prior-philip/AirSuspension_ESP32/hardware/FCU/FCU.csv

Reference | Qty | Value | DNP | Exclude from BOM | Exclude from Board | Footprint | Datasheet
C1 | 1 | 470uF |  |  |  | Capacitor_THT:CP_Radial_D14.0mm_P5.00mm | ~
C2 | 1 | 47uF |  |  |  | Capacitor_THT:CP_Radial_D12.5mm_P5.00mm | ~
C3,C4 | 2 | 47pF |  |  |  | Capacitor_THT:C_Rect_L7.0mm_W3.5mm_P5.00mm | ~
C5 | 1 | 10uF |  |  |  | Capacitor_THT:CP_Radial_D5.0mm_P2.50mm | ~
C6,C7,C8 | 3 | 470pF |  |  |  | Capacitor_THT:C_Rect_L7.0mm_W3.5mm_P5.00mm | ~
D1,D2,D3,D4 | 4 | 1N4003 |  |  |  | Diode_THT:D_DO-41_SOD81_P2.54mm_Vertical_AnodeUp
J1 | 1 | Pneumatic Valves |  |  |  | Connector_PinHeader_2.54mm:PinHeader_1x08_P2.54mm_Vertical | ~
J2 | 1 | UP/DOWN Switch |  |  |  | Connector_PinHeader_2.54mm:PinHeader_1x04_P2.54mm_Vertical | ~
J3 | 1 | OLED Display |  |  |  | Connector_PinHeader_2.54mm:PinHeader_1x04_P2.54mm_Vertical | ~
J4 | 1 | NiveauSensor |  |  |  | Connector_PinHeader_2.54mm:PinHeader_1x06_P2.54mm_Vertical | ~
J5 | 1 | Power In |  |  |  | Connector_PinHeader_2.54mm:PinHeader_1x04_P2.54mm_Vertical | ~
Q1,Q2,Q3,Q4 | 4 | IRLU120 |  |  |  | Package_TO_SOT_THT:TO-220-3_Vertical | https://www.vishay.com/docs/91326/sihlz24.pdf
R1,R2,R3,R4 | 4 | 10k |  |  |  | Resistor_THT:R_Axial_DIN0207_L6.3mm_D2.5mm_P10.16mm_Horizontal | ~
U1 | 1 | LM7805_TO220 |  |  |  | Package_TO_SOT_THT:TO-220-3_Vertical | https://www.onsemi.cn/PowerSolutions/document/MC7800-D.PDF
U2 | 1 | Arduino_Nano_v3.x |  |  |  | Module:Arduino_Nano | http://www.mouser.com/pdfdocs/Gravitech_Arduino_Nano3_0.pdf
