prior-philip/AirSuspension_ESP32/hardware/FCU/Documents/FCU.pdf

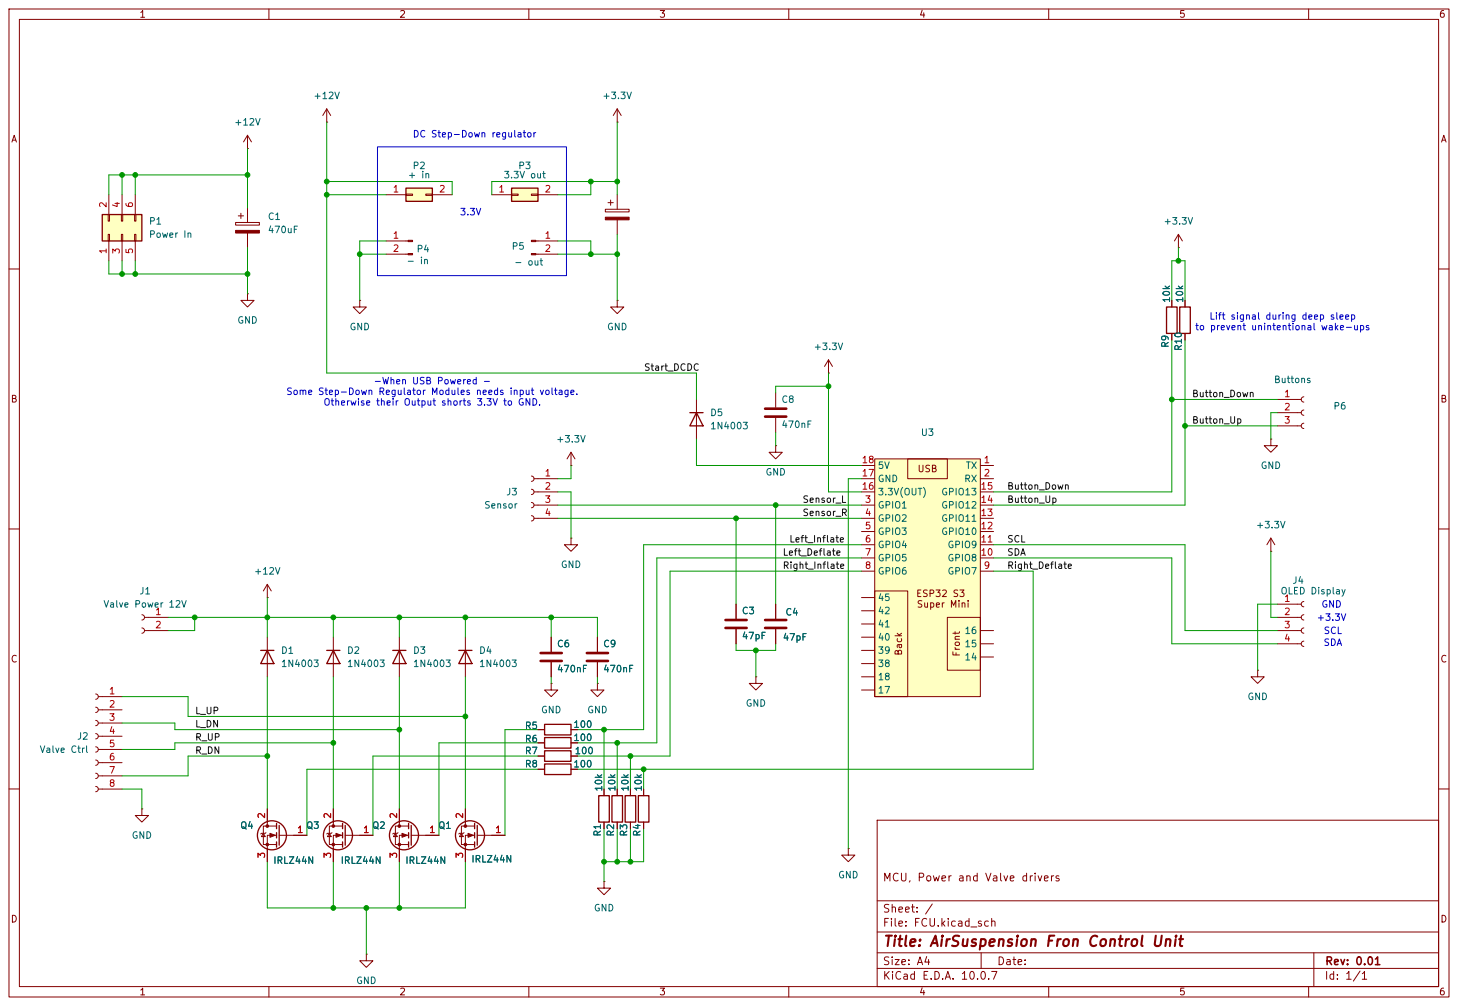
[picture p1: page 1]

to prevent unintentional wake-ups 3.3V Q1

Lift signal during deep sleep

MCU, Power and Valve drivers GND

Sheet: /
File: FCU.kicad_sch
Title: AirSuspension Fron Control Unit

Size: A4 | Rev: 0.01
KiCad E.D.A. 10.0.7 | Id: 1/1
