prior-philip/AirSuspension_ESP32/hardware/RCU/Output/RCU.pdf

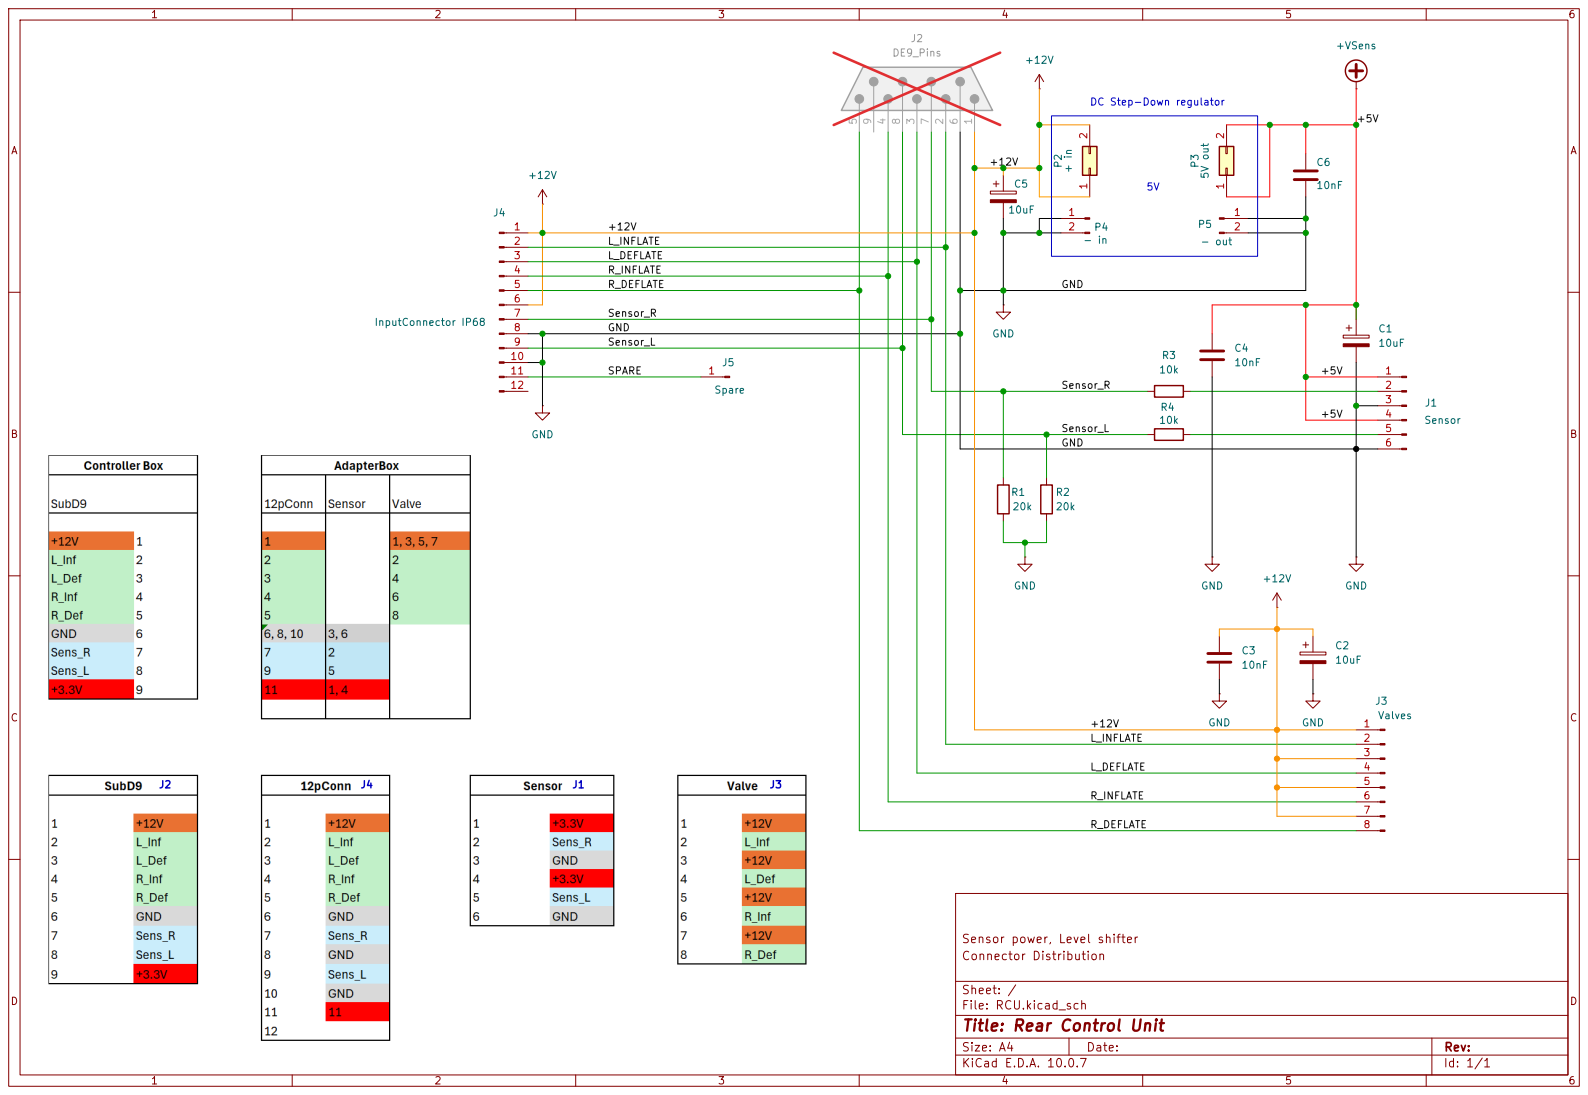
[picture p2: page 1]

5V DC Step-Down regulator

Sheet: /
File: RCU.kicad_sch
Title: Rear Control Unit

Size: A4 | Rev:
KiCad E.D.A. 10.0.7 | Id: 1/1
