prior-philip/AirSuspension_ESP32/hardware/FCU/Documents/VW-1234-20001/VW-1234-20001-ASMTOP.pdf

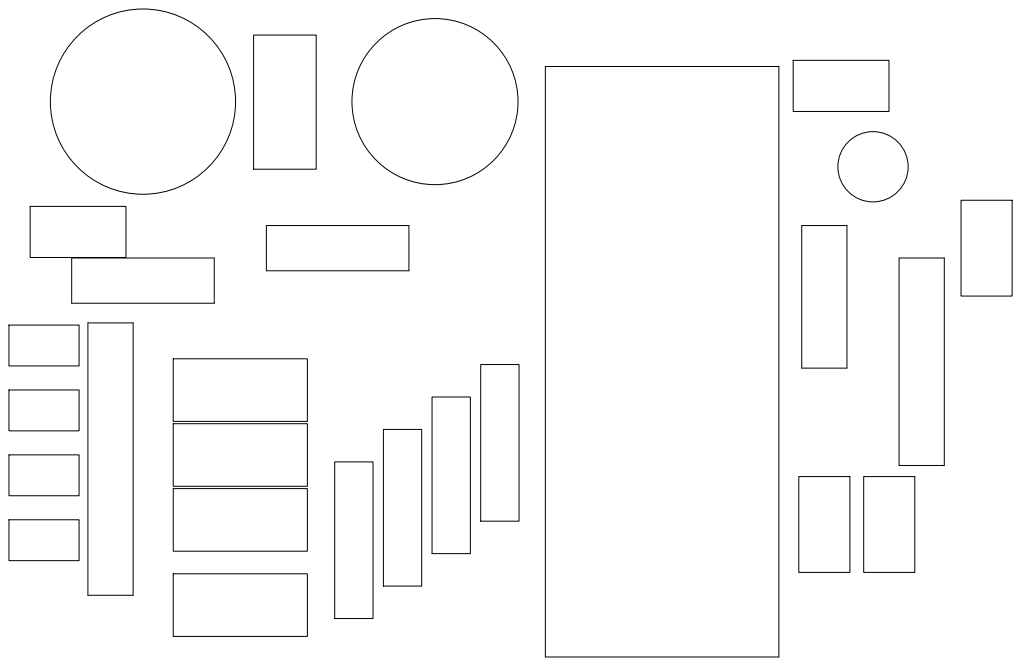
[picture p4: page 1]

Id: 1/1 Title: File: AirSuspension.kicad_pcb Sheet:
