prior-philip/AirSuspension_ESP32/hardware/FCU/Documents/VW-1234-20001/VW-1234-20001-SCH.pdf

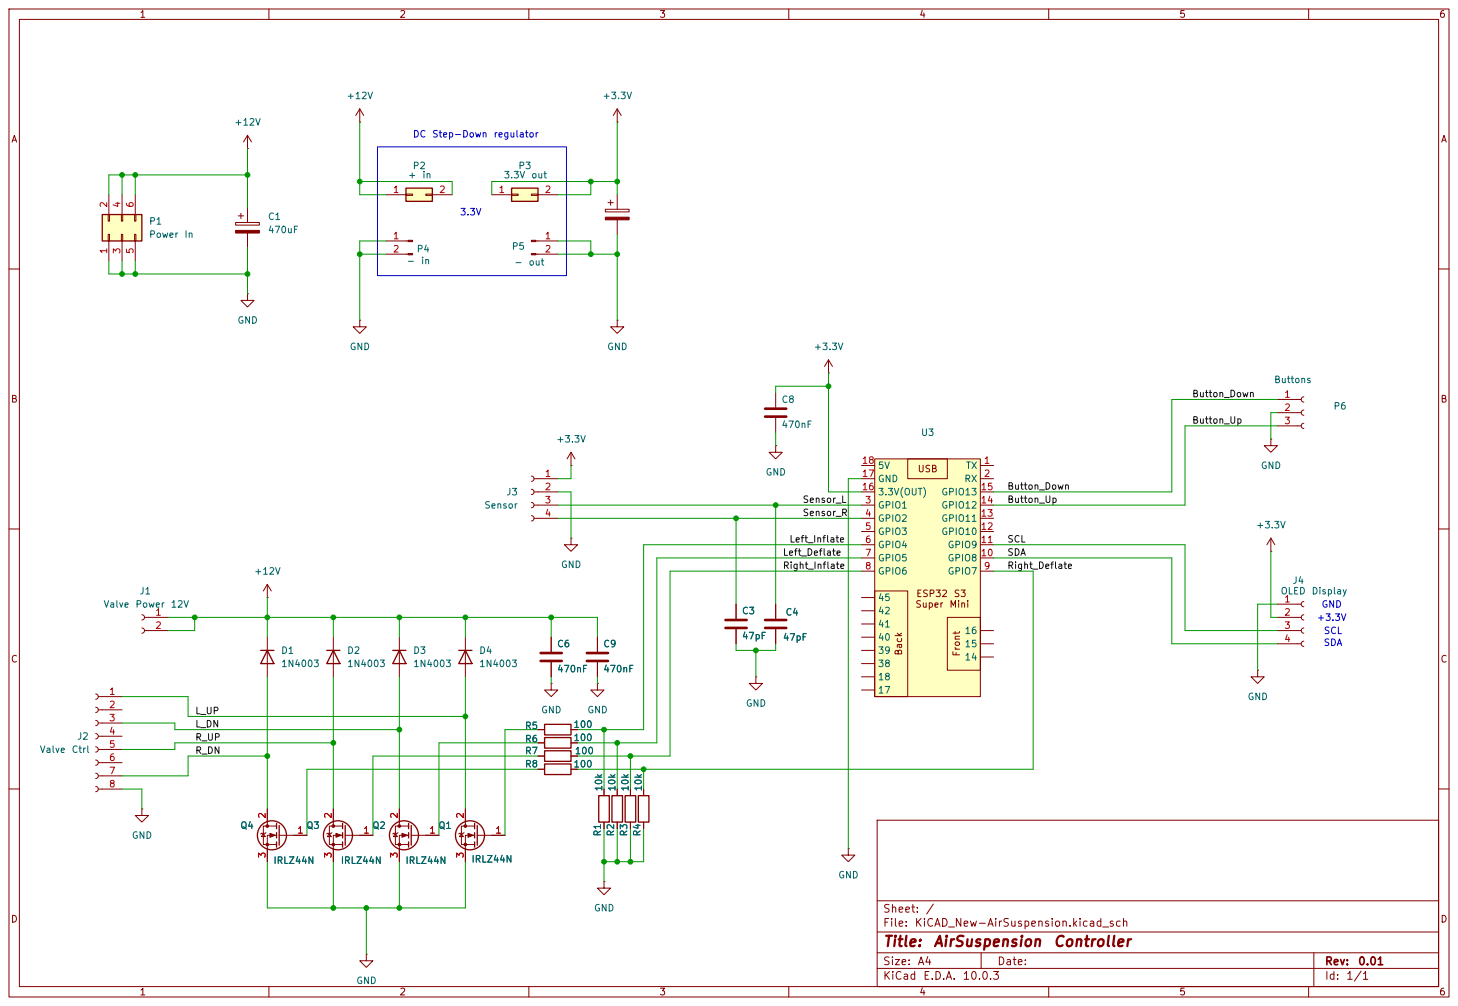
[picture p5: page 1]

Size: A4 | Rev: 0.01
KiCad E.D.A. 10.0.3 | Id: 1/1
