prior-philip/AirSuspension_ESP32/hardware/FCU/Documents/schemtic.pdf

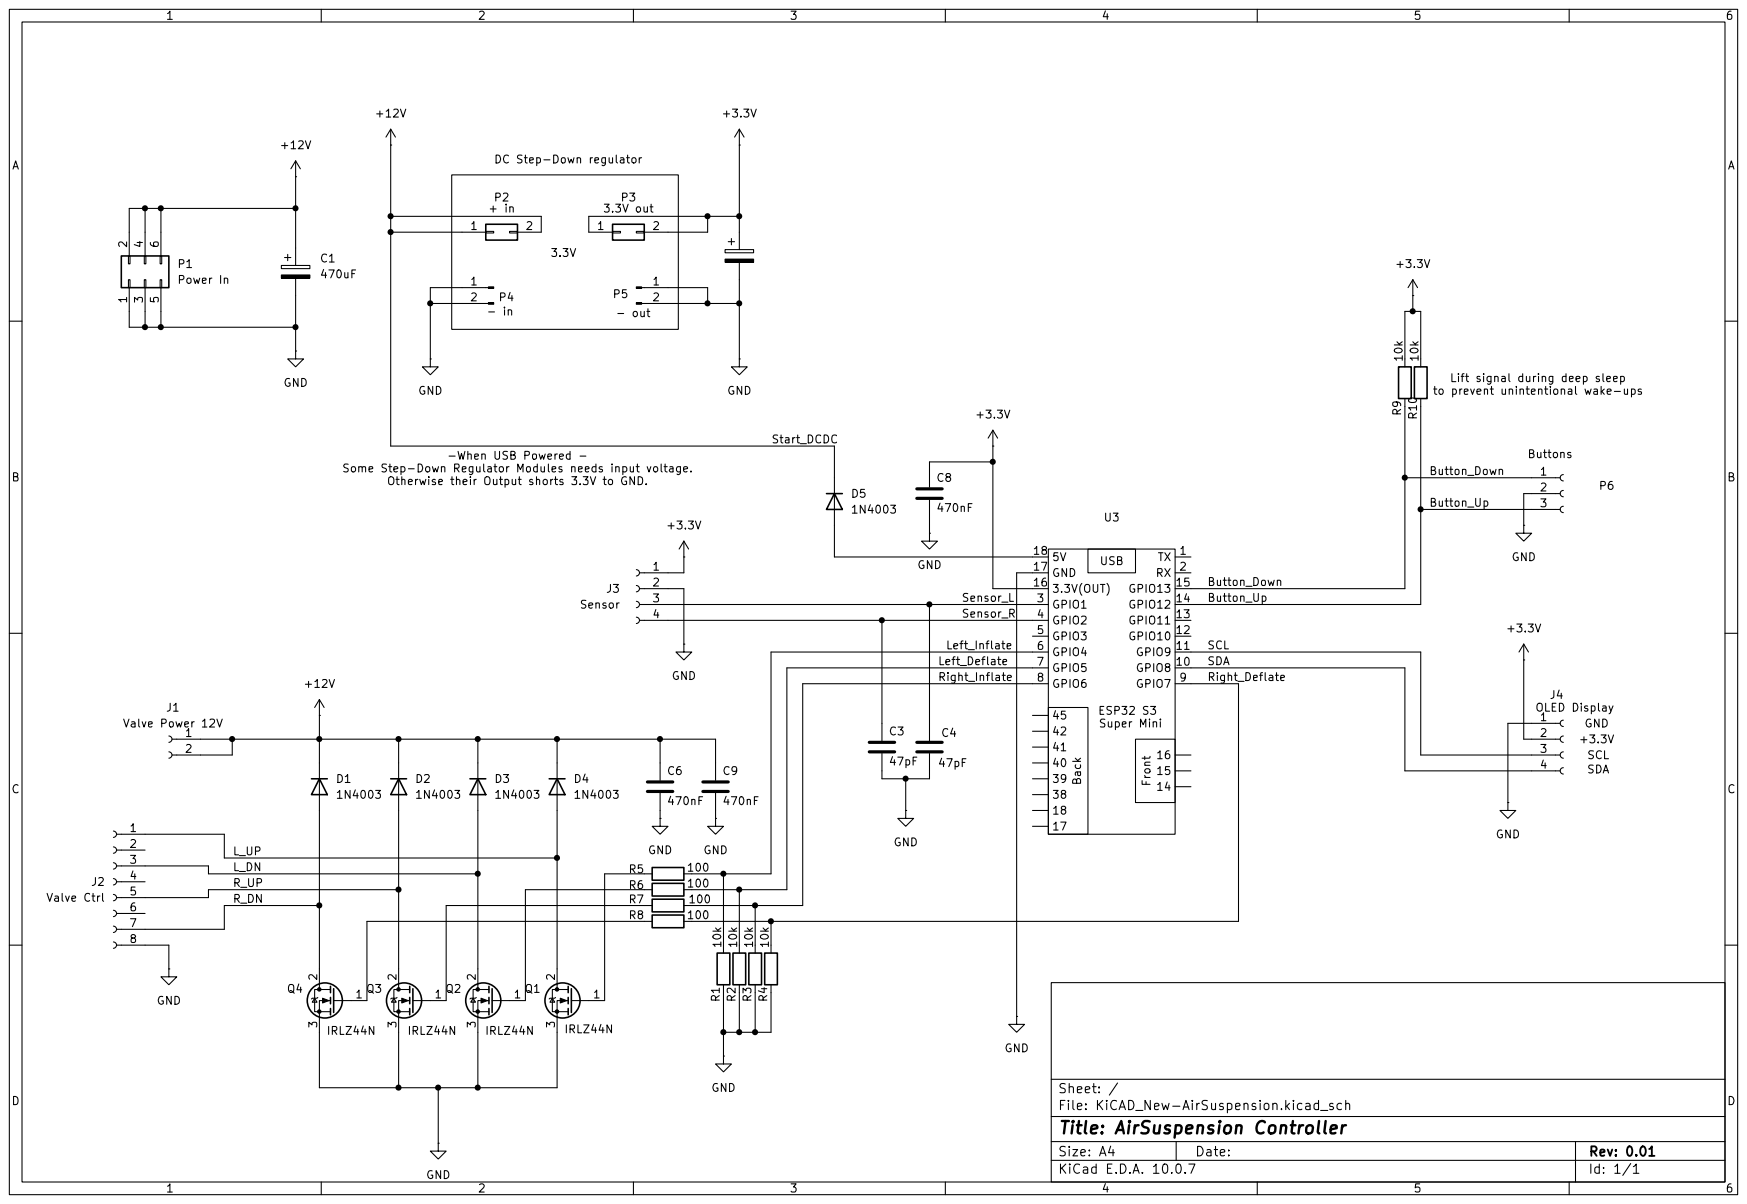
[picture p6: page 1]
