prior-philip/AirSuspension_ESP32/hardware/FCU/Documents/VW-1234-20001/KiCAD_New-AirSuspension-F_Mask.pdf

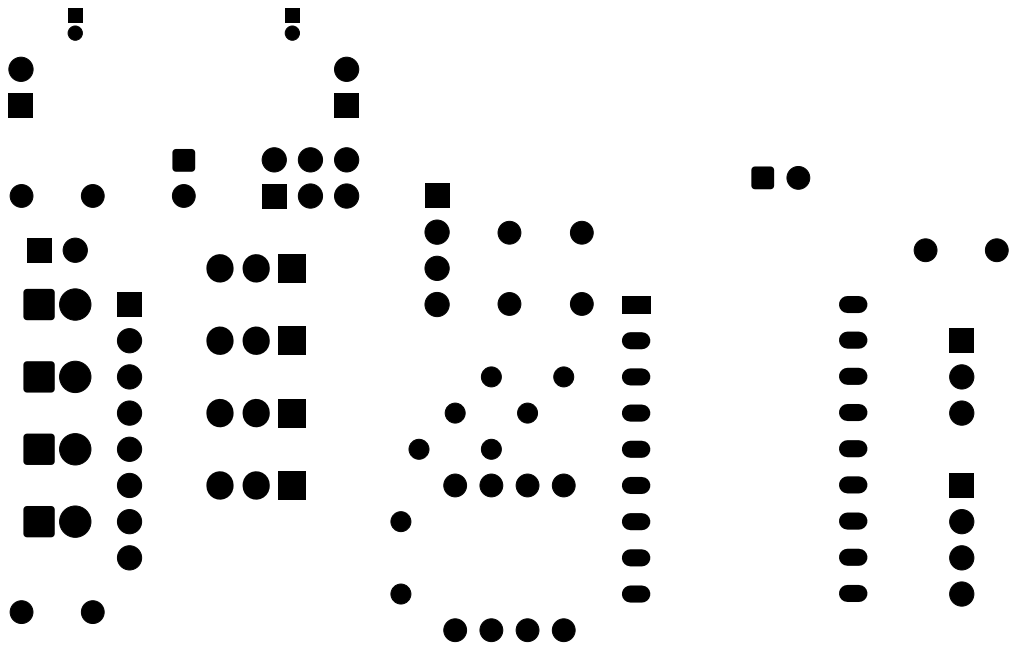
[picture p7: page 1]
