prior-philip/AirSuspension_ESP32/hardware/FCU/FCU.kicad_pcb

## KiCad design hardware/FCU/FCU.kicad_pcb (2026-10-25)

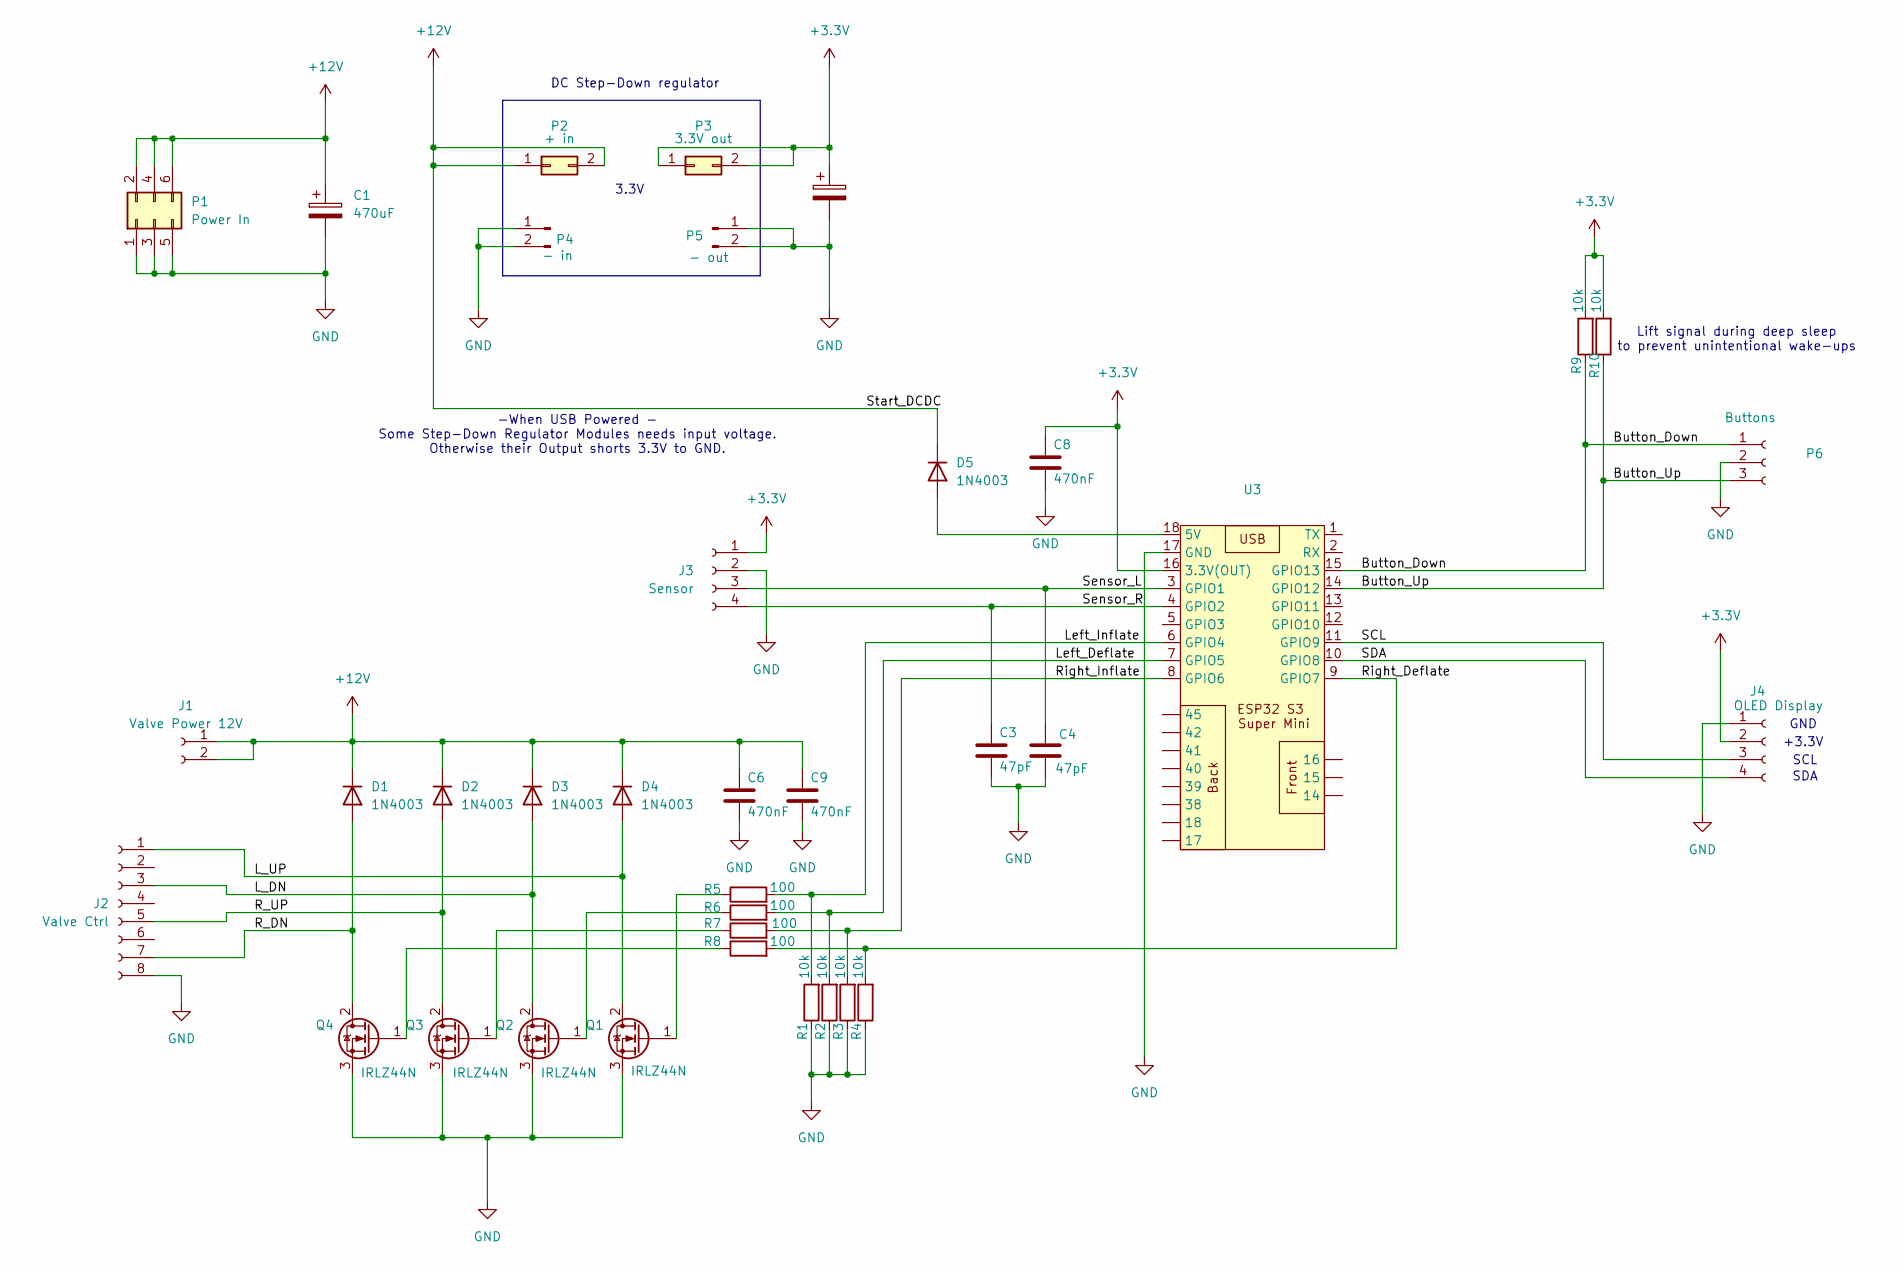
[picture p9: schematic FCU.kicad_sch, AirSuspension Fron Control Unit]

Parts:
C1: 470uF; CP_Radial_D6.3mm_P2.50mm
C2: 47uF; CP_Radial_D6.3mm_P2.50mm
C3, C4: 47pF; C_Rect_L7.0mm_W3.5mm_P5.00mm
C6, C8, C9: 470nF; C_Rect_L7.0mm_W3.5mm_P5.00mm
D1, D2, D3, D4: 1N4003; D_DO-41_SOD81_P2.54mm_Vertical_AnodeUp
D5: 1N4003; D_A-405_P10.16mm_Horizontal
J1: Valve Power 12V; PinSocket_1x02_P2.54mm_Vertical
J2: Valve Ctrl; PinSocket_1x08_P2.54mm_Vertical
J3: Sensor; PinSocket_1x04_P2.54mm_Vertical
J4: OLED Display; PinSocket_1x04_P2.54mm_Vertical
P1: Power In; PinHeader_2x03_P2.54mm_Vertical
P2: + in; PinHeader_2x01_P2.54mm_Horizontal
P3: 3.3V out; PinHeader_2x01_P2.54mm_Horizontal
P4: - in; PinHeader_1x02_P1.27mm_Vertical
P5: - out; PinHeader_1x02_P1.27mm_Vertical
P6: Buttons; PinHeader_1x03_P2.54mm_Vertical
Q1, Q2, Q3, Q4: IRLZ44N; TO-220-3_Vertical
R1, R2, R3, R4, R9: 10k; R_Axial_DIN0207_L6.3mm_D2.5mm_P10.16mm_Horizontal
R5, R6, R7, R8: 100; R_Axial_DIN0204_L3.6mm_D1.6mm_P5.08mm_Horizontal
R10: 10k; R_Axial_DIN0207_L6.3mm_D2.5mm_P2.54mm_Vertical
U3: ESP32-S3-SuperMini

Connections:
+3.3V: C2.1, C8.1, J3.1, J4.2, P3.1, P3.2, R9.2, R10.2, U3.16 (3.3V(OUT))
+12V: C1.1, C6.1, C9.1, D1.1 (K), D2.1 (K), D3.1 (K), D4.1 (K), D5.1 (K), J1.1, J1.2, P1.2, P1.4, P1.6, P2.1, P2.2
/Button_Down: P6.1, R9.1, U3.15 (GPIO13)
/Button_Up: P6.3, R10.1, U3.14 (GPIO12)
/L_DN: D3.2 (A), J2.3, Q2.2 (D)
/L_UP: D4.2 (A), J2.1, Q1.2 (D)
/Left_Deflate: R2.2, R6.2, U3.7 (GPIO5)
/Left_Inflate: R1.2, R5.2, U3.6 (GPIO4)
/R_DN: D1.2 (A), J2.7, Q4.2 (D)
/R_UP: D2.2 (A), J2.5, Q3.2 (D)
/Right_Deflate: R4.2, R8.2, U3.9 (GPIO7)
/Right_Inflate: R3.2, R7.2, U3.8 (GPIO6)
/SCL: J4.3, U3.11 (GPIO9)
/SDA: J4.4, U3.10 (GPIO8)
/Sensor_L: C4.1, J3.3, U3.3 (GPIO1)
/Sensor_R: C3.1, J3.4, U3.4 (GPIO2)
GND: C1.2, C2.2, C3.2, C4.2, C6.2, C8.2, C9.2, J2.8, J3.2, J4.1, P1.1, P1.3, P1.5, P4.1, P4.2, P5.1, P5.2, P6.2, Q1.3 (S), Q2.3 (S), Q3.3 (S), Q4.3 (S), R1.1, R2.1, R3.1, R4.1, U3.17 (GND)
unnamed: D5.2 (A), U3.18 (5V)
unnamed: Q1.1 (G), R5.1
unnamed: Q2.1 (G), R6.1
unnamed: Q3.1 (G), R7.1
unnamed: Q4.1 (G), R8.1

Notes on the sheet:
GND
-When USB Powered - Some Step-Down Regulator Modules needs input voltage. Otherwise their Output shorts 3.3V to GND.
DC Step-Down regulator
SDA
3.3V
+3.3V
Lift signal during deep sleep to prevent unintentional wake-ups
SCL

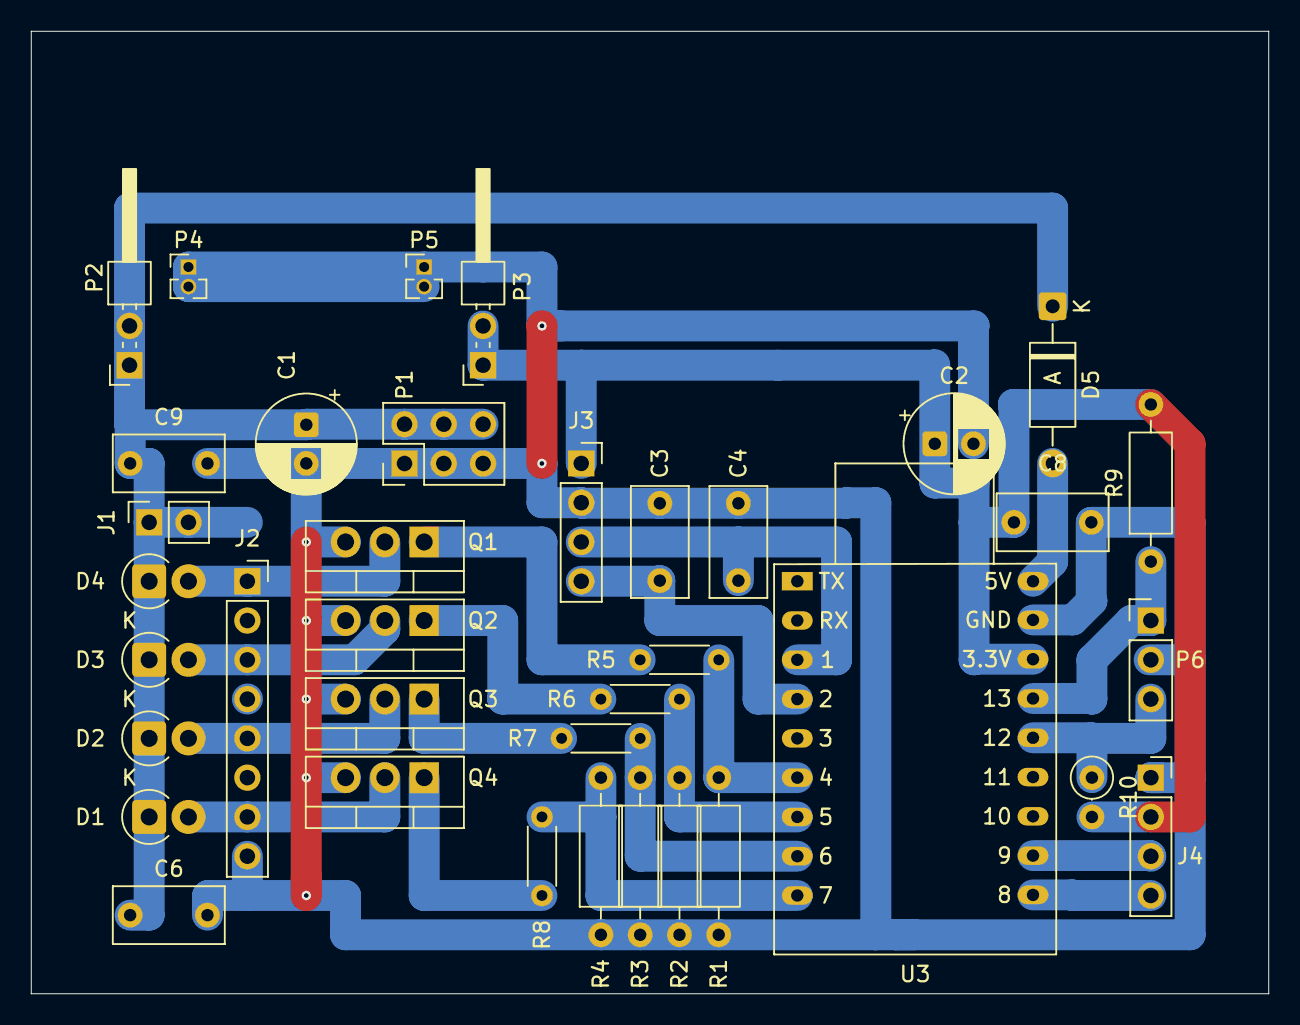
[picture p10: board FCU.kicad_pcb from above]

Board: 2 copper layers, 80.0 x 62.2 mm, 37 parts (0 on the bottom side), 22 nets.
