prior-philip/AirSuspension_ESP32/hardware/RCU/RCU.kicad_pcb

## KiCad design hardware/RCU/RCU.kicad_pcb (2026-10-25)

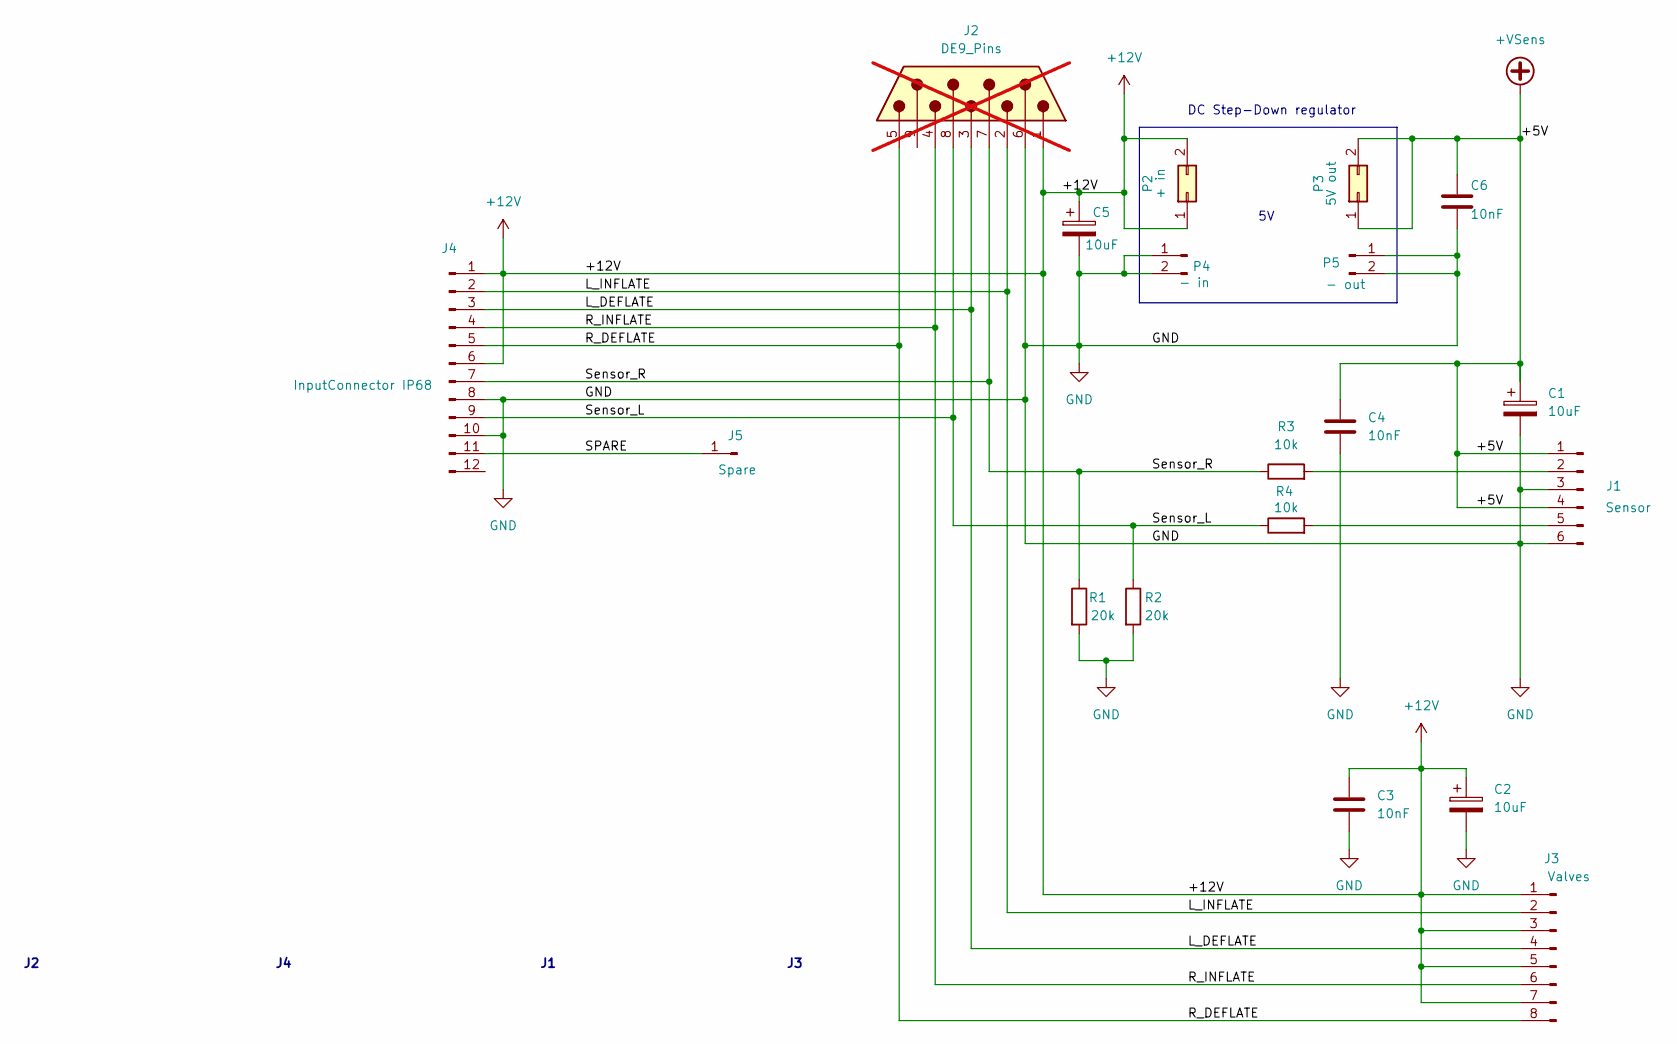
[picture p11: schematic RCU.kicad_sch]

Parts:
C1, C2, C5: 10uF; CP_Radial_D5.0mm_P2.50mm
C3, C6: 10nF; C_Disc_D4.3mm_W1.9mm_P5.00mm
C4: 10nF; C_Disc_D5.1mm_W3.2mm_P5.00mm
J1: Sensor; PinHeader_1x06_P2.54mm_Vertical
J2: DE9_Pins; DSUB-9_Pins_Vertical_P2.77x2.84mm; not fitted
J3: Valves; PinHeader_1x08_P2.54mm_Vertical
J4: InputConnector IP68; PinHeader_1x12_P2.54mm_Vertical
J5: Spare; PinHeader_1x01_P2.54mm_Vertical
P2: + in; PinHeader_2x01_P2.54mm_Horizontal
P3: 5V out; PinHeader_2x01_P2.54mm_Horizontal
P4: - in; PinHeader_1x02_P2.54mm_Vertical
P5: - out; PinHeader_1x02_P2.54mm_Vertical
R1, R2: 20k; R_Axial_DIN0207_L6.3mm_D2.5mm_P10.16mm_Horizontal
R3, R4: 10k; R_Axial_DIN0207_L6.3mm_D2.5mm_P10.16mm_Horizontal

Connections:
+12V: C2.1, C3.1, C5.1, J2.1, J3.1, J3.3, J3.5, J3.7, J4.1, J4.6, P2.1, P2.2
+VSens: C1.1, C4.1, C6.1, J1.1, J1.4, P3.1, P3.2
/L_DEFLATE: J2.3, J3.4, J4.3
/L_INFLATE: J2.2, J3.2, J4.2
/R_DEFLATE: J2.5, J3.8, J4.5
/R_INFLATE: J2.4, J3.6, J4.4
/SPARE: J4.11, J5.1 (Pin_1_1)
/Sensor_L: J2.8, J4.9, R2.1, R4.1
/Sensor_R: J2.7, J4.7, R1.1, R3.1
GND: C1.2, C2.2, C3.2, C4.2, C5.2, C6.2, J1.3, J1.6, J2.6, J4.8, J4.10, P4.1, P4.2, P5.1, P5.2, R1.2, R2.2
unnamed: J1.2, R3.2
unnamed: J1.5, R4.2

Notes on the sheet:
DC Step-Down regulator

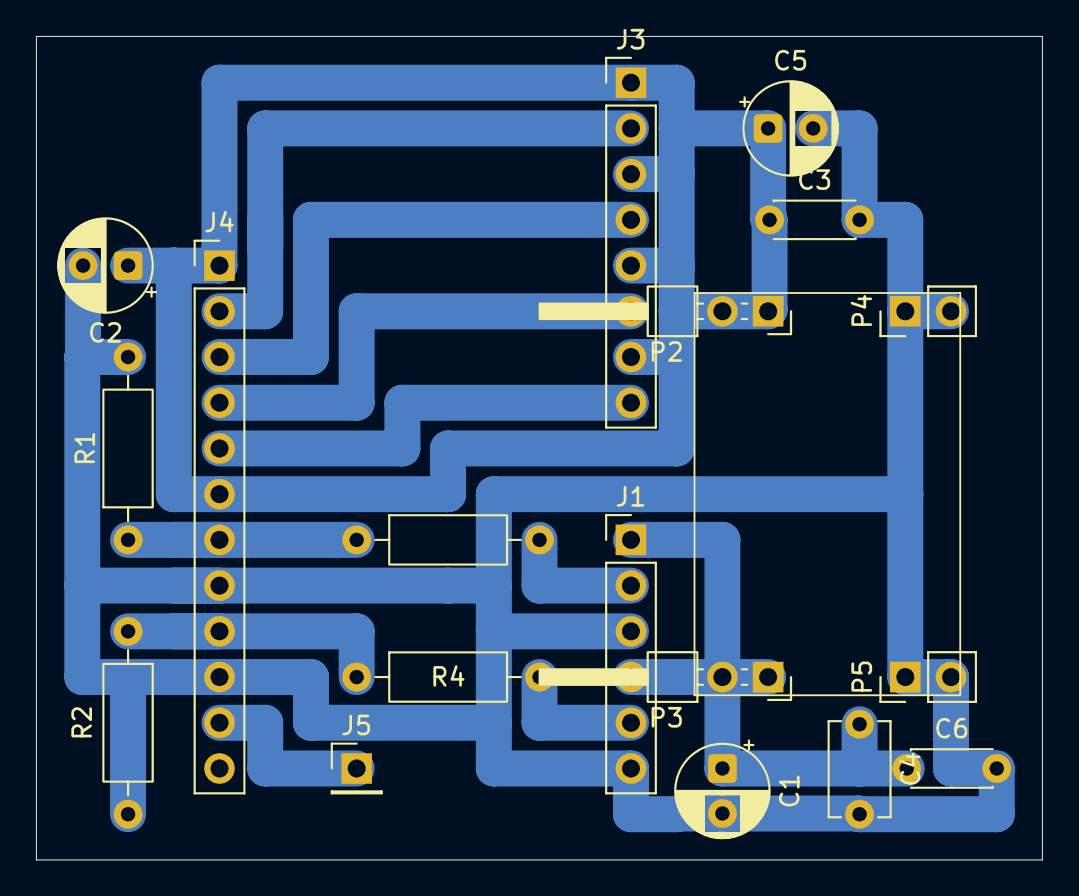
[picture p12: board RCU.kicad_pcb from above]

Board: 2 copper layers, 55.9 x 45.7 mm, 18 parts (0 on the bottom side), 12 nets.
