prior-philip/AirSuspension_ESP32/hardware/FCU/AirSuspension.kicad_pcb

## KiCad design hardware/FCU/AirSuspension.kicad_pcb (2026-10-25)

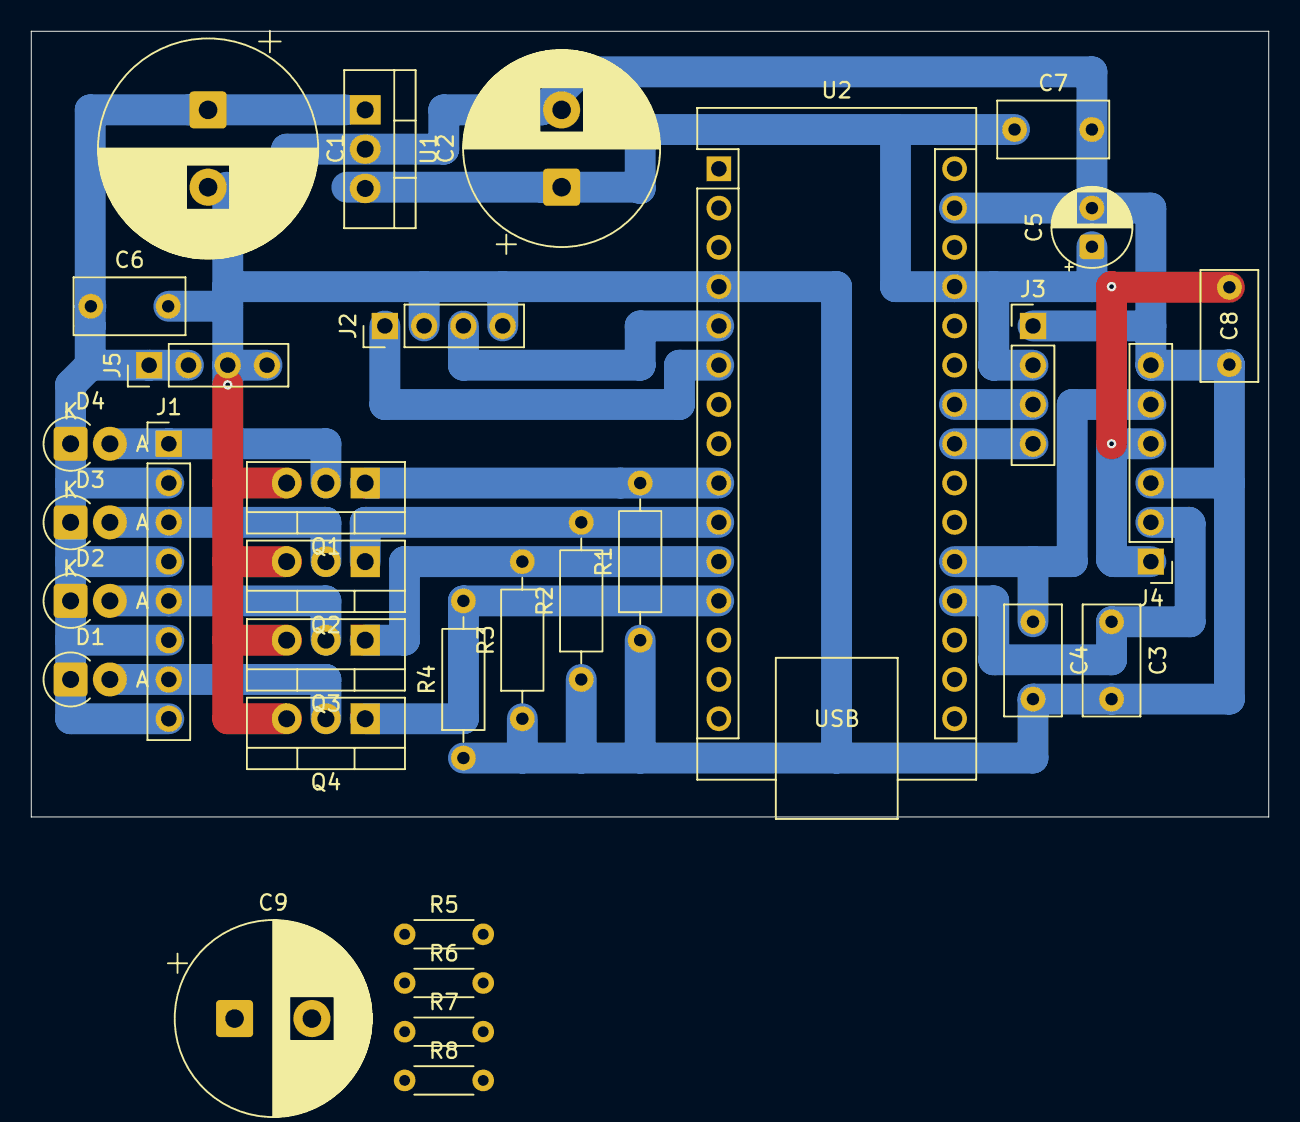
[picture p13: board AirSuspension.kicad_pcb from above]

Board: 2 copper layers, 80.0 x 50.8 mm, 32 parts (0 on the bottom side), 21 nets.

Parts:
C1: 470uF; CP_Radial_D14.0mm_P5.00mm
C2: 47uF; CP_Radial_D12.5mm_P5.00mm
C3, C4: 47pF; C_Rect_L7.0mm_W3.5mm_P5.00mm
C5: 10uF; CP_Radial_D5.0mm_P2.50mm
C6: 47nF; C_Rect_L7.0mm_W3.5mm_P5.00mm
C7, C8: 470pF; C_Rect_L7.0mm_W3.5mm_P5.00mm
C9: 470uF; CP_Radial_D12.5mm_P5.00mm
D1, D2, D3, D4: 1N4003; D_DO-41_SOD81_P2.54mm_Vertical_AnodeUp
J1: Pneumatic Valves; PinHeader_1x08_P2.54mm_Vertical
J2: UP/DOWN Switch; PinHeader_1x04_P2.54mm_Vertical
J3: OLED Display; PinHeader_1x04_P2.54mm_Vertical
J4: NiveauSensor; PinHeader_1x06_P2.54mm_Vertical
J5: Power In; PinHeader_1x04_P2.54mm_Vertical
Q1, Q2, Q3, Q4: IRLU120; TO-220-3_Vertical
R1, R2, R3, R4: 10k; R_Axial_DIN0207_L6.3mm_D2.5mm_P10.16mm_Horizontal
R5, R6, R7, R8: 100; R_Axial_DIN0204_L3.6mm_D1.6mm_P5.08mm_Horizontal
U1: LM7805_TO220; TO-220-3_Vertical
U2: Arduino_Nano_v3.x; Arduino_Nano

Connections:
+5V: C2.1, C5.1, C7.1, C8.1, J3.2, J4.1, J4.4, U1.3 (VO), U2.27 (+5V)
+12V: C1.1, C6.1, C9.1, D1.1 (K), D2.1 (K), D3.1 (K), D4.1 (K), J1.2, J1.4, J1.6, J1.8, J5.1, J5.2, U1.1 (VI)
/Button_Down: J2.1, U2.6 (D3)
/Button_Up: J2.3, U2.5 (D2)
/Left_Deflate: D3.2 (A), J1.3, Q2.2 (D)
/Left_Inflate: D4.2 (A), J1.1, Q1.2 (D)
/Right_Deflate: D1.2 (A), J1.7, Q4.2 (D)
/Right_Inflate: D2.2 (A), J1.5, Q3.2 (D)
/SCL: J3.3, U2.24 (A5)
/SDA: J3.4, U2.23 (A4)
/Sens_L: C3.1, J4.2, U2.19 (A0)
/Sens_R: C4.1, J4.5, U2.20 (A1)
GND: C1.2, C2.2, C3.2, C4.2, C5.2, C6.2, C7.2, C8.2, C9.2, J2.2, J2.4, J3.1, J4.3, J4.6, J5.3, J5.4, Q1.3 (S), Q2.3 (S), Q3.3 (S), Q4.3 (S), R1.1, R2.1, R3.1, R4.1, U1.2 (GND), U2.4 (GND), U2.29 (GND)
unnamed: Q1.1 (G), R5.1
unnamed: Q2.1 (G), R6.1
unnamed: Q3.1 (G), R7.1
unnamed: Q4.1 (G), R8.1
unnamed: R1.2, R5.2, U2.9 (D6)
unnamed: R2.2, R6.2, U2.10 (D7)
unnamed: R3.2, R7.2, U2.11 (D8)
unnamed: R4.2, R8.2, U2.12 (D9)
