prior-philip/AirSuspension_ESP32/(commit log)

2026-10-25 Move sketch into AirSuspension/, add CI build for ESP32S3 Dev Module
    Claude-Session: https://claude.ai/code/session_01FTE8Ug1pKnLNxdBVUBhTtd
2026-10-25 changing esp32 core version
2026-10-25 Update build.yml to include paths for triggers
    Add paths filter for push and pull_request events in build workflow.
2026-10-25 Add KiCad projects FCU and RCU, layout docs
    [AirSuspension.kicad_pcb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]
2026-10-25 Add hardware READMEs for FCU and RCU
    [FCU.kicad_pcb, FCU.kicad_sch, RCU.kicad_sch]
2026-10-25 Update hardware READMEs, add schematic PDFs
2026-10-25 Shorten USB wait to 0.5 s, drop periodic display re-init
    [AirSuspension.ino]
